bobby1321/Battery_Charger_Balancer/Battery_Charger_Balancer_2/digikey_cart.xlsx

Digi-Key: Shopping Cart
Index | Quantity | Part Number | Manufacturer Part Number | Description | Customer Reference | Available | Backorder | Unit Price | Extended Price USD
1 | 10 | 4518-FDS6681ZCT-ND | FDS6681Z | MOSFET P-CH 30V 20A 8SOIC |  | 10 | 0 | 0.761 | 7.61
2 | 50 | 13-AC0603FR-136K04LCT-ND | AC0603FR-136K04L | RES 6.04K OHM 1% 1/10W 0603 |  | 50 | 0 | 0.0052 | 0.26
3 | 50 | 311-2.2HRCT-ND | RC0603FR-072R2L | RES 2.2 OHM 1% 1/10W 0603 |  | 50 | 0 | 0.0102 | 0.51
4 | 50 | 311-41.2KHRCT-ND | RC0603FR-0741K2L | RES 41.2K OHM 1% 1/10W 0603 |  | 50 | 0 | 0.0062 | 0.31
5 | 50 | 311-5.36KHRCT-ND | RC0603FR-075K36L | RES 5.36K OHM 1% 1/10W 0603 |  | 50 | 0 | 0.0062 | 0.31
6 | 50 | 311-13.7KHRCT-ND | RC0603FR-0713K7L | RES 13.7K OHM 1% 1/10W 0603 |  | 50 | 0 | 0.0056 | 0.28
7 | 50 | 311-22.0KHRCT-ND | RC0603FR-0722KL | RES 22K OHM 1% 1/10W 0603 |  | 50 | 0 | 0.0062 | 0.31
8 | 50 | 311-2.20KHRCT-ND | RC0603FR-072K2L | RES 2.2K OHM 1% 1/10W 0603 |  | 50 | 0 | 0.0062 | 0.31
9 | 50 | 311-10.0KHRCT-ND | RC0603FR-0710KL | RES 10K OHM 1% 1/10W 0603 |  | 50 | 0 | 0.0072 | 0.36
10 | 50 | 311-453KHRCT-ND | RC0603FR-07453KL | RES 453K OHM 1% 1/10W 0603 |  | 50 | 0 | 0.0062 | 0.31
11 | 50 | 311-0.0GRCT-ND | RC0603JR-070RL | RES 0 OHM JUMPER 1/10W 0603 |  | 50 | 0 | 0.0068 | 0.34
12 | 50 | 1276-6700-1-ND | CL10B471KC8WPNC | CAP CER 470PF 100V X7R 0603 |  | 50 | 0 | 0.0336 | 1.68
13 | 50 | 587-3170-1-ND | UMK107B7474KA-TR | CAP CER 0.47UF 50V X7R 0603 |  | 50 | 0 | 0.0594 | 2.97
14 | 50 | 399-C0603C103K5RACTUCT-ND | C0603C103K5RACTU | CAP CER 10000PF 50V X7R 0603 |  | 50 | 0 | 0.009 | 0.45
15 | 50 | 399-C0603C102K5RACTUCT-ND | C0603C102K5RACTU | CAP CER 1000PF 50V X7R 0603 |  | 50 | 0 | 0.009 | 0.45
16 | 50 | 1276-1063-1-ND | CL10B473KB8NNNC | CAP CER 0.047UF 50V X7R 0603 |  | 50 | 0 | 0.0194 | 0.97
17 | 100 | 490-7205-1-ND | GRM188R6YA475KE15D | CAP CER 4.7UF 35V X5R 0603 |  | 100 | 0 | 0.086 | 8.60
18 | 50 | 587-3247-1-ND | UMK107AB7105KA-T | CAP CER 1UF 50V X7R 0603 |  | 50 | 0 | 0.029 | 1.45
19 | 50 | 311-1344-1-ND | CC0603KRX7R9BB104 | CAP CER 0.1UF 50V X7R 0603 |  | 50 | 0 | 0.0176 | 0.88
20 | 20 | 1276-6886-1-ND | CIGT201208EH1R0MNE | FIXED IND 1UH 3.1A 55 MOHM SMD |  | 20 | 0 | 0.159 | 3.18
21 | 5 | 563-1091-1-ND | CSS-1210TB | SWITCH SLIDE SPDT 100MA 12V |  | 5 | 0 | 0.72 | 3.60
22 | 10 | 13-PA0603FRE570R01LCT-ND | PA0603FRE570R01L | RES 0.01 OHM 1% 1/2W 0603 |  | 10 | 0 | 0.126 | 1.26
23 | 50 | 516-1434-1-ND | HSMG-C170 | LED GREEN DIFFUSED CHIP SMD |  | 50 | 0 | 0.194 | 9.70
24 | 10 | 1727-2913-1-ND | BAV74,215 | DIODE ARRAY GP 50V 215MA TO236AB |  | 10 | 0 | 0.082 | 0.82
25 | 10 | 264-TCR1HF33B,LM(CT-ND | TCR1HF33B,LM(CT | IC REG LINEAR 3.3V 150MA SMV |  | 10 | 0 | 0.198 | 1.98
26 | 10 | P19785CT-ND | ETQ-P4M100KVC | FIXED IND 10UH 7.6A 27.94 MOHM |  | 10 | 0 | 0.675 | 6.75
27 | 5 | 296-BQ25690RBARCT-ND | BQ25690RBAR | STAND-ALONE OR IC-CONTROLLED 40V |  | 0 | 5 | 5.03 | 25.15
28 | 5 | 1028-RT1719GQWCT-ND | RT1719GQW | USB TYPE-C PD CONTR WQFN-20 |  | 5 | 0 | 2.81 | 14.05
29 | 10 | 490-13961-1-ND | BLM18SN220TN1D | FERRITE BEAD 22 OHM 0603 1LN |  | 10 | 0 | 0.131 | 1.31
30 | 10 | 664-GSB1C41110SSHRCT-ND | GSB1C41110SSHR | USB2.0, TYPE C, TOP MOUNT, CENTE |  | 10 | 0 | 0.566 | 5.66
31 | 10 | 4518-UMWIRF8788TRCT-ND | UMWIRF8788TR | MOSFET N-CH 30V 24A 8SOIC |  | 10 | 0 | 0.967 | 9.67
