bobby1321/Battery_Charger_Balancer/Battery_Charger_Balancer_2/Battery_Charger_Balancer_2.pdf

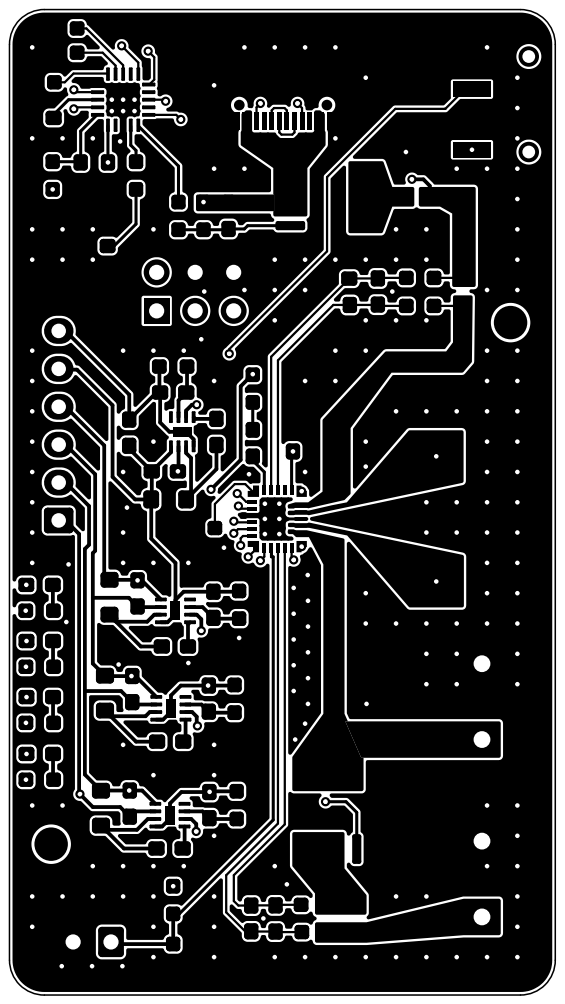
[picture p2: page 1]
