bobby1321/Battery_Charger_Balancer/Battery_Charger_Balancer/Battery_Charger_Balancer.kicad_pcb

## KiCad design Battery_Charger_Balancer/Battery_Charger_Balancer.kicad_pcb (2026-11-11)

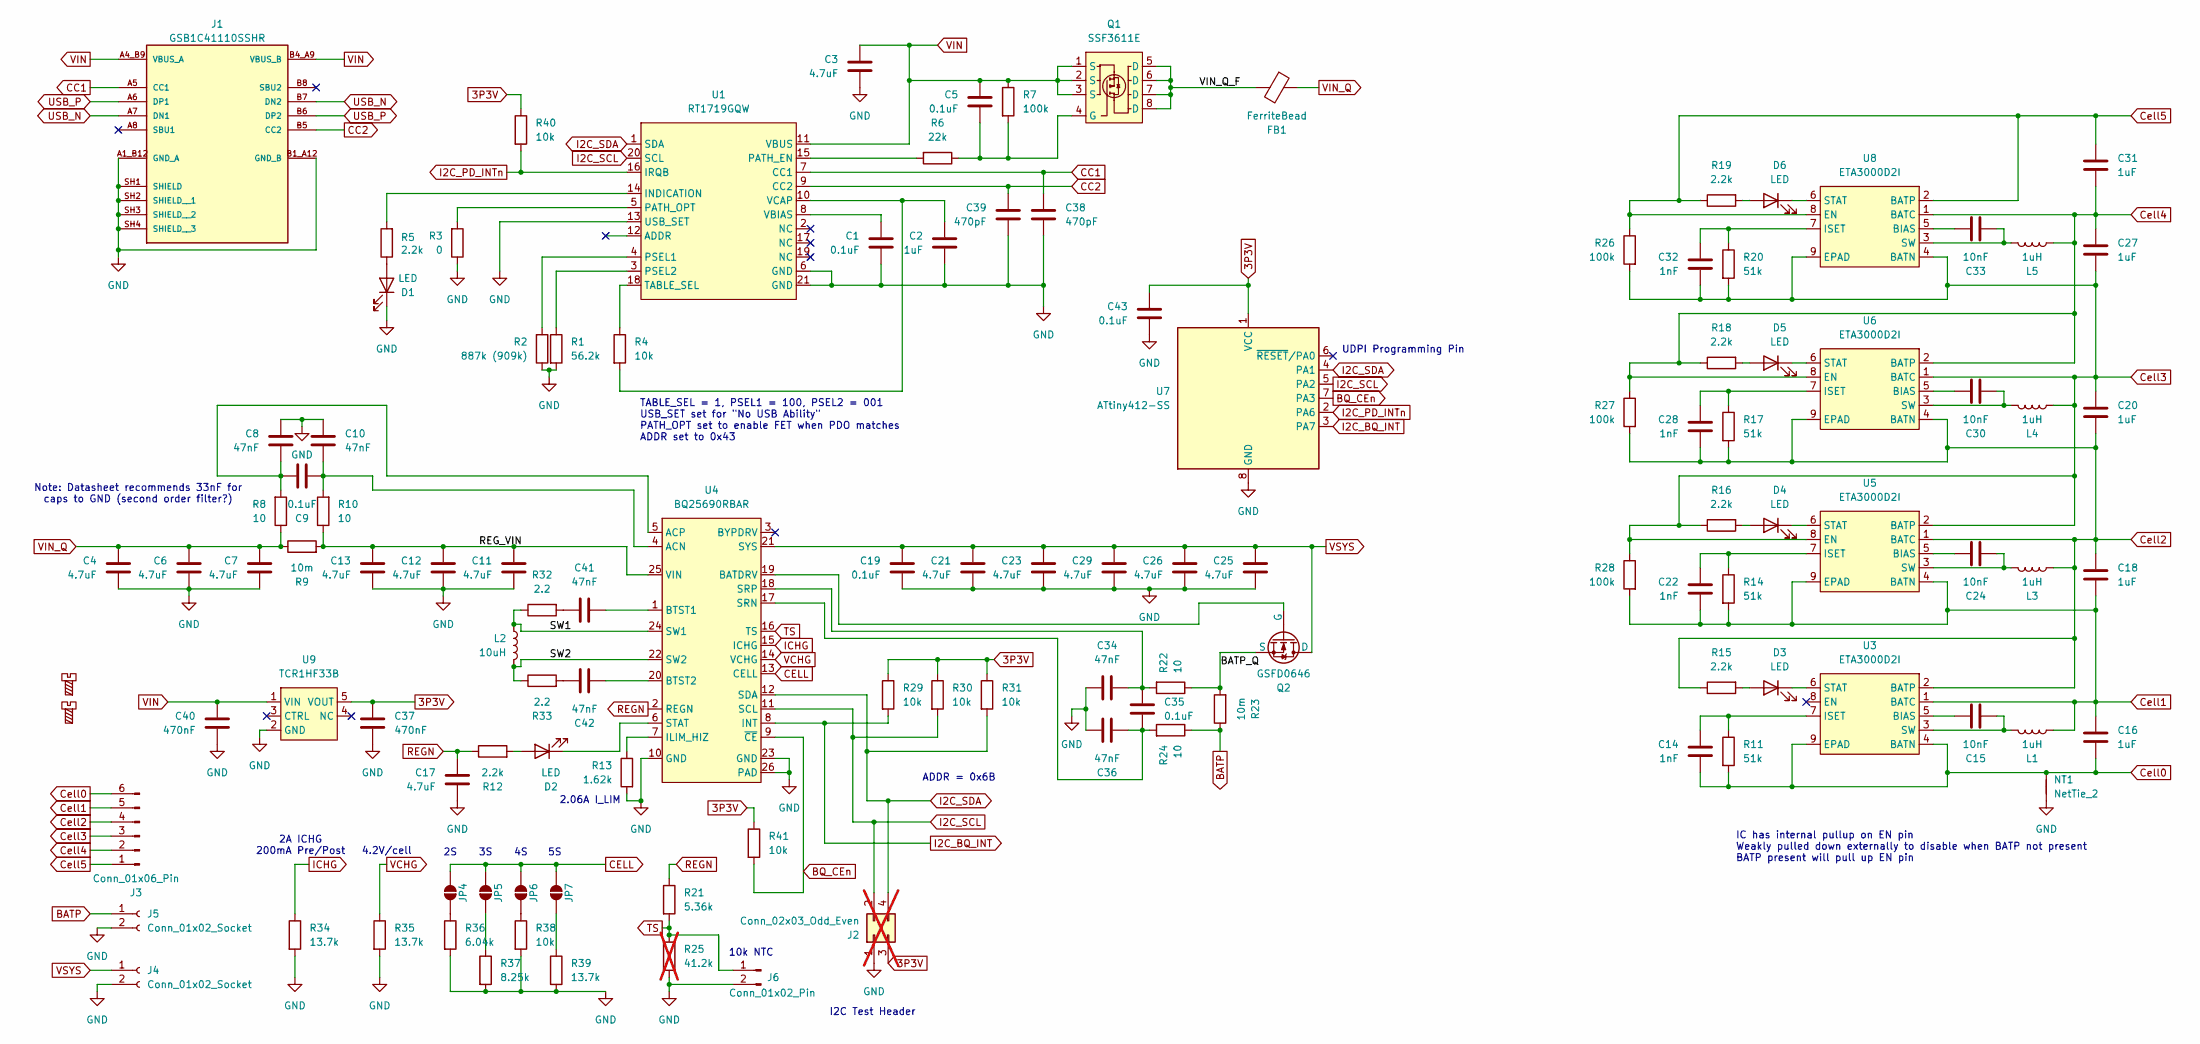
[picture p3: schematic Battery_Charger_Balancer.kicad_sch]

Parts:
C1, C5, C9, C19, C35, C43: 0.1uF; C_0603_1608Metric_Pad1.08x0.95mm_HandSolder
C2, C16, C18, C20, C27, C31: 1uF; C_0603_1608Metric_Pad1.08x0.95mm_HandSolder
C3, C4, C6, C7, C11, C12, C13, C17, C21, C23, C25, C26, C29: 4.7uF; C_0603_1608Metric_Pad1.08x0.95mm_HandSolder
C8, C10, C34, C36, C41, C42: 47nF; C_0603_1608Metric_Pad1.08x0.95mm_HandSolder
C14, C22, C28, C32: 1nF; C_0603_1608Metric_Pad1.08x0.95mm_HandSolder
C15, C24, C30, C33: 10nF; C_0603_1608Metric_Pad1.08x0.95mm_HandSolder
C37, C40: 470nF; C_0603_1608Metric_Pad1.08x0.95mm_HandSolder
C38, C39: 470pF; C_0603_1608Metric_Pad1.08x0.95mm_HandSolder
D1, D2, D3, D4, D5, D6: LED; LED_0603_1608Metric_Pad1.05x0.95mm_HandSolder
FB1: FerriteBead; L_0603_1608Metric_Pad1.05x0.95mm_HandSolder
H1, H2: MountingScrew; MountingHole_2.2mm_M2
J1: GSB1C41110SSHR; AMPHENOL_GSB1C41110SSHR; PARTREV AX1
J2: Conn_02x03_Odd_Even; PinHeader_2x02_P2.54mm_Vertical; not fitted
J3: Conn_01x06_Pin; JST_XH_B6B-XH-A_1x06_P2.50mm_Vertical
J4, J5: Conn_01x02_Socket; TerminalBlock_RND_205-00045_1x02_P5.00mm_Horizontal
J6: Conn_01x02_Pin; JST_XH_B2B-XH-A_1x02_P2.50mm_Vertical
JP4, JP5, JP6, JP7: SolderJumper_2_Open; Solder_Jumper_0603
L1, L3, L4, L5: 1uH; L_0805_2012Metric_Pad1.05x1.20mm_HandSolder
L2: 10uH; IND_PCC-M0748M-LE_PAN
NT1: NetTie_2; NetTie-2_SMD_Pad0.5mm
Q1: SSF3611E; SOIC-8_3.9x4.9mm_P1.27mm
Q2: GSFD0646; TO-252-2
R1: 56.2k; R_0603_1608Metric_Pad0.98x0.95mm_HandSolder
R2: 887k (909k); R_0603_1608Metric_Pad0.98x0.95mm_HandSolder
R3: 0; R_0603_1608Metric_Pad0.98x0.95mm_HandSolder
R4, R29, R30, R31, R38, R40, R41: 10k; R_0603_1608Metric_Pad0.98x0.95mm_HandSolder
R5, R12, R15, R16, R18, R19: 2.2k; R_0603_1608Metric_Pad0.98x0.95mm_HandSolder
R6: 22k; R_0603_1608Metric_Pad0.98x0.95mm_HandSolder
R7, R26, R27, R28: 100k; R_0603_1608Metric_Pad0.98x0.95mm_HandSolder
R8, R10, R22, R24: 10; R_0603_1608Metric_Pad0.98x0.95mm_HandSolder
R9, R23: 10m; R_1206_3216Metric_Pad1.30x1.75mm_HandSolder
R11, R14, R17, R20: 51k; R_0603_1608Metric_Pad0.98x0.95mm_HandSolder
R13: 1.62k; R_0603_1608Metric_Pad0.98x0.95mm_HandSolder
R21: 5.36k; R_0603_1608Metric_Pad0.98x0.95mm_HandSolder
R25: 41.2k; R_0603_1608Metric_Pad0.98x0.95mm_HandSolder; not fitted
R32, R33: 2.2; R_0603_1608Metric_Pad0.98x0.95mm_HandSolder
R34, R35, R39: 13.7k; R_0603_1608Metric_Pad0.98x0.95mm_HandSolder
R36: 6.04k; R_0603_1608Metric_Pad0.98x0.95mm_HandSolder
R37: 8.25k; R_0603_1608Metric_Pad0.98x0.95mm_HandSolder
U1: RT1719GQW; QFN-20-1EP_3.5x3.5mm_P0.5mm_EP2x2mm
U3, U5, U6, U8: ETA3000D2I; DFN-8-1EP_2x2mm_P0.5mm_EP0.6x1.2mm
U4: BQ25690RBAR; WQFN-26_L4.0-W3.5_BQ25690RBAR
U7: ATtiny412-SS; SOIC-8_3.9x4.9mm_P1.27mm
U9: TCR1HF33B; SC-74A-5_1.55x2.9mm_P0.95mm

Connections:
3P3V: C37.1, C43.1, J2.3, R29.1, R30.1, R31.1, R40.1, R41.1, U7.1 (VCC), U9.5 (VOUT)
/REG_VIN: C11.1, C12.1, C13.1, R9.2, R10.1, U4.25 (VIN)
/SW1: L2.2, R32.1, U4.24 (SW1)
/SW2: L2.1, R33.1, U4.22 (SW2)
/VIN_Q_F: FB1.2, Q1.5 (D), Q1.6 (D), Q1.7 (D), Q1.8 (D); also elsewhere on the board
BATP: J5.1, R23.1, R24.1
BQ_CEn: R41.2, U4.9 (~CE), U7.7 (PA3)
CC1: C38.1, J1.A5 (CC1), U1.7 (CC1)
CC2: C39.1, J1.B5 (CC2), U1.9 (CC2)
CELL: JP4.2 (B), JP5.2 (B), JP6.2 (B), JP7.2 (B), U4.13 (CELL)
Cell0: C14.2, C16.2, J3.6, NT1.2, R11.2, U3.4 (BATN), U3.9 (EPAD)
Cell1: C16.1, C18.2, C22.2, J3.5, L1.2, R14.2, R28.2, U3.1 (BATC), U5.4 (BATN), U5.9 (EPAD)
Cell2: C18.1, C20.2, C28.2, J3.4, L3.2, R15.1, R17.2, R27.2, U3.2 (BATP), U5.1 (BATC), U6.4 (BATN), U6.9 (EPAD)
Cell3: C20.1, C27.2, C32.2, J3.3, L4.2, R16.1, R20.2, R26.2, R28.1, U5.2 (BATP), U5.8 (EN), U6.1 (BATC), U8.4 (BATN), U8.9 (EPAD)
Cell4: C27.1, C31.2, J3.2, L5.2, R18.1, R27.1, U6.2 (BATP), U6.8 (EN), U8.1 (BATC)
Cell5: C31.1, J3.1, R19.1, R26.1, U8.2 (BATP), U8.8 (EN)
GND: C1.2, C2.2, C3.2, C4.2, C6.2, C7.2, C8.1, C10.1, C11.2, C12.2, C13.2, C17.2, C19.2, C21.2, C23.2, C25.2, C26.2, C29.2, C34.2, C36.2, C37.2, C38.2, C39.2, C40.2, C43.2, D1.1 (K), J1.A1_B12 (GND_A), J1.B1_A12 (GND_B), J1.SH1 (SHIELD), J1.SH2 (SHIELD__1), J1.SH3 (SHIELD__2), J1.SH4 (SHIELD__3), J2.1, J4.2, J5.2, J6.2, NT1.1, R1.2, R2.1, R3.1, R13.2, R25.2, R34.2, R35.2, R36.2, R37.2, R38.2, R39.2, U1.6 (GND), U1.13 (USB_SET), U1.21 (GND), U4.10 (GND), U4.23 (GND), U4.26 (PAD), U7.8 (GND), U9.2 (GND)
I2C_BQ_INT: R29.2, U4.8 (INT), U7.3 (PA7)
I2C_PD_INTn: R40.2, U1.16 (IRQB), U7.2 (PA6)
I2C_SCL: J2.2, R30.2, U1.20 (SCL), U4.11 (SCL), U7.5 (PA2)
I2C_SDA: J2.4, R31.2, U1.1 (SDA), U4.12 (SDA), U7.4 (PA1)
ICHG: R34.1, U4.15 (ICHG)
unnamed: C41.2, R32.2
unnamed: C42.2, R33.2
unnamed: D1.2 (A), R5.1
unnamed: D2.2 (A), R12.2
unnamed: D2.1 (K), U4.6 (STAT)
unnamed: D3.2 (A), R15.2
unnamed: D3.1 (K), U3.6 (STAT)
unnamed: D4.2 (A), R16.2
unnamed: D4.1 (K), U5.6 (STAT)
unnamed: D5.2 (A), R18.2
unnamed: D5.1 (K), U6.6 (STAT)
unnamed: D6.2 (A), R19.2
unnamed: D6.1 (K), U8.6 (STAT)
unnamed: JP4.1 (A), R36.1
unnamed: JP5.1 (A), R37.1
unnamed: JP6.1 (A), R38.1
unnamed: JP7.1 (A), R39.1
unnamed: R5.2, U1.14 (INDICATION)
unnamed: R6.2, U1.15 (PATH_EN)
unnamed: R3.2, U1.5 (PATH_OPT)
unnamed: R2.2, U1.4 (PSEL1)
unnamed: R1.1, U1.3 (PSEL2)
unnamed: R4.1, U1.18 (TABLE_SEL)
unnamed: C1.1, U1.8 (VBIAS)
unnamed: C2.1, R4.2, U1.10 (VCAP)
unnamed 47: C5.2, Q1.4 (G), R6.1, R7.2; also elsewhere on the board
unnamed: C15.2, U3.5 (BIAS)
unnamed: C14.1, R11.1, U3.7 (ISET)
unnamed: C15.1, L1.1, U3.3 (SW)
unnamed: C9.1, C10.2, R10.2, U4.4 (ACN)
unnamed: C8.2, C9.2, R8.2, U4.5 (ACP)
unnamed: C41.1, U4.1 (BTST1)
unnamed: C42.1, U4.20 (BTST2)
unnamed: R13.1, U4.7 (ILIM_HIZ)
unnamed: C35.2, C36.1, R24.2, U4.17 (SRN)
unnamed: C34.1, C35.1, R22.2, U4.18 (SRP)
unnamed: C24.2, U5.5 (BIAS)
unnamed: C22.1, R14.1, U5.7 (ISET)
unnamed: C24.1, L3.1, U5.3 (SW)
unnamed: C30.2, U6.5 (BIAS)
unnamed: C28.1, R17.1, U6.7 (ISET)
unnamed: C30.1, L4.1, U6.3 (SW)
unnamed: C33.2, U8.5 (BIAS)
unnamed: C32.1, R20.1, U8.7 (ISET)
unnamed: C33.1, L5.1, U8.3 (SW)
REGN: C17.1, R12.1, R21.1, U4.2 (REGN)
TS: J6.1, R21.2, R25.1, U4.16 (TS)
USB_N: J1.A7 (DN1), J1.B7 (DN2)
USB_P: J1.A6 (DP1), J1.B6 (DP2)
VCHG: R35.1, U4.14 (VCHG)
VIN_Q: C4.1, C6.1, C7.1, FB1.1, R8.1, R9.1

Notes on the sheet:
4.2V/cell
UDPI Programming Pin
2.06A I_LIM
Note: Datasheet recommends 33nF for caps to GND (second order filter?)
2A ICHG 200mA Pre/Post
10k NTC
I2C Test Header
ADDR = 0x6B
IC has internal pullup on EN pin Weakly pulled down externally to disable when BATP not present BATP present will pull up EN pin
TABLE_SEL = 1, PSEL1 = 100, PSEL2 = 001 USB_SET set for "No USB Ability" PATH_OPT set to enable FET when PDO matches ADDR set to 0x43

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
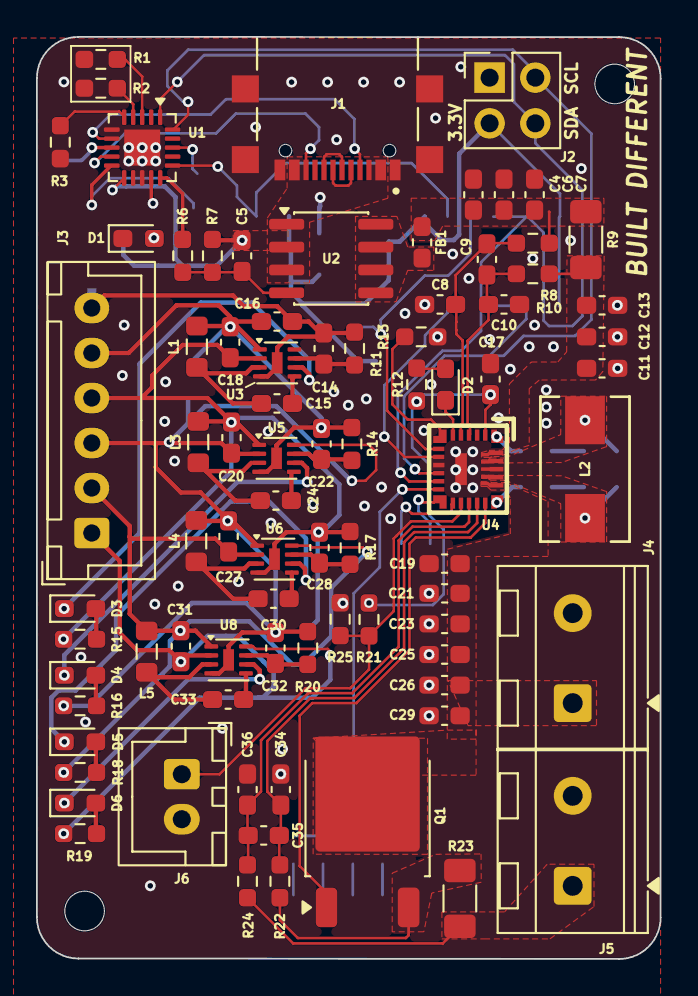
[picture p4: board Battery_Charger_Balancer.kicad_pcb from above]

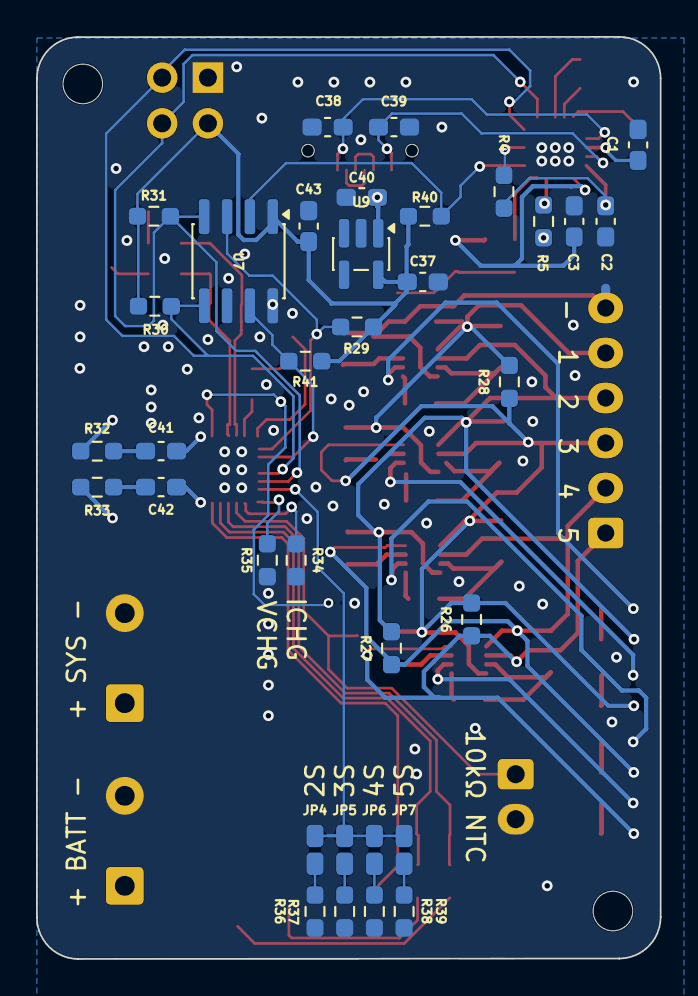
[picture p5: board Battery_Charger_Balancer.kicad_pcb from below]

Board: 2 copper layers, 34.6 x 51.2 mm, 119 parts (35 on the bottom side), 77 nets.

Other parts of the board:
U2: SSF3611E; SOIC-8_3.9x4.9mm_P1.27mm

Their connections:
/VIN_Q_F: U2.5 (D), U2.6 (D), U2.7 (D), U2.8 (D); also elsewhere on the board
unnamed 47: U2.4 (G); also elsewhere on the board
