bobby1321/Battery_Charger_Balancer/(commit log)

2026-05-10 Updates after production of first rev
    [Battery_Charger_Balancer_2.csv, Battery_Charger_Balancer_2.kicad_pcb, Battery_Charger_Balancer_2.kicad_sch, bom.csv, designators.csv, positions.csv]
2026-05-17 Finial version of the original design
    [Battery_Charger_Balancer_2.csv, Battery_Charger_Balancer_2.kicad_sch]
